ShangqunYu/Dash48V/README.md

# Dash48V
48v version motor controller board
