ShangqunYu/Dash48V/v1.0/production/Sample-BOM_JLCSMT (3).xlsx

Comment | Designator | Footprint | JLCPCB Part #（optional）
GRM32EC72A106KE05L | C1, C2, C3, C4, C5, C6, C7, C8, C9, C10, C11, C12, C13, C14, C15, C16, C17, C18, C19, C21 | GRM32EC72A106KE05L | GRM32EC72A106KE05L
CL31B105KCHNNNE | C20 | CL31B105KCHNNNE | CL31B105KCHNNNE
GRM21BC72A105KE01L | C22, C28, C29, C30 | GRM21BC72A105KE01L | GRM21BC72A105KE01L
CC0603KRX7R0BB473 | C23 | CC0603KRX7R0BB473 | CC0603KRX7R0BB473
CL10B104KC8NNNC | C24, C47, C48, C49, C50, C51, C52, C53, C54, C55, C56, C57 | CL10B104KC8NNNC | CL10B104KC8NNNC
GRM155R60J475ME87D | C26 | GRM155R60J475ME87D | GRM155R60J475ME87D
CL31B225KCHSNNE | C37 | CL31B225KCHSNNE | CL31B225KCHSNNE
CL10B222KB8NNNC | C38 | CL10B222KB8NNNC | CL10B222KB8NNNC
GRM31CR61E476ME44L | C39 | GRM31CR61E476ME44L | GRM31CR61E476ME44L
GRM32ER71E226KE15L | C40, C41 | GRM32ER71E226KE15L | GRM32ER71E226KE15L
CC0402JRNPO9BN560 | C42 | CC0402JRNPO9BN560 | CC0402JRNPO9BN560
CL10B332KB8NNNC | C43 | CL10B332KB8NNNC | CL10B332KB8NNNC
EFVH100ADA101M10C0 | CC1, CC2 | EFVH100ADA101M10C0 | EFVH100ADA101M10C0
XT30(2+2)PB-M.G.B | CN3(OUT)1, CN3(OUT)2 | XT30(2+2)PB-M.G.B | XT30(2+2)PB-M.G.B
LTST-C190KGKT | D1 | LTST-C190KGKT | LTST-C190KGKT
LTST-C191KRKT | D2 | LTST-C191KRKT | LTST-C191KRKT
BLM18AG601SN1D | FL1 | BLM18AG601SN1D | BLM18AG601SN1D
BM07B-GHS-TBT | J1 | BM07B-GHS-TBT | BM07B-GHS-TBT
BM06B-GHS-TBT(LF)(SN) | J2 | BM06B-GHS-TBT(LF)(SN) | BM06B-GHS-TBT(LF)(SN)
Conn_01x02_Pin | J3 | Conn_01x02_Pin | Conn_01x02_Pin
VLS5045EX-680M | L1 | VLS5045EX-680M | VLS5045EX-680M
DFE252012PD-2R2M=P2 | L2, L3 | DFE252012PD-2R2M=P2 | DFE252012PD-2R2M=P2
FDMT80080DC | Q1, Q2, Q3, Q4, Q5, Q6 | FDMT80080DC | FDMT80080DC
RT0402DRE0710KL | R2, R5 | RT0402DRE0710KL | RT0402DRE0710KL
RC0402FR-0710KL | R3, R4 | RC0402FR-0710KL | RC0402FR-0710KL
RT0603DRD07200KL | R6 | RT0603DRD07200KL | RT0603DRD07200KL
RC0402JR-07200RL | R7, R8 | RC0402JR-07200RL | RC0402JR-07200RL
ARG03BTC4533 | R9, R15 | ARG03BTC4533 | ARG03BTC4533
RC0402FR-0742K2L | R10 | RC0402FR-0742K2L | RC0402FR-0742K2L
RC0402FR-0780K6L | R11 | RC0402FR-0780K6L | RC0402FR-0780K6L
RC0402FR-0752K3L | R12 | RC0402FR-0752K3L | RC0402FR-0752K3L
RC0805FR-07100KL | R13 | RC0805FR-07100KL | RC0805FR-07100KL
RT0603BRD0749K9L | R14 | RT0603BRD0749K9L | RT0603BRD0749K9L
WSLF25121L000FEA | R16, R17, R18 | WSLF25121L000FEA | WSLF25121L000FEA
+5V TestPoint | TP3 | +5V TestPoint | +5V TestPoint
+3.3V TestPoint | TP4 | +3.3V TestPoint | +3.3V TestPoint
TP_Can_tx | TP5, TP6 | TP_Can_tx | TP_Can_tx
TP_CS | TP12 | TP_CS | TP_CS
STM32F446RET6 | U1 | STM32F446RET6 | STM32F446RET6
DRV8353SRTAR | U2 | DRV8353SRTAR | DRV8353SRTAR
MCP2542FD-E/MF | U3 | MCP2542FD-E/MF | MCP2542FD-E/MF
MA732GQ-Z | U4 | MA732GQ-Z | MA732GQ-Z
TPS629203DRLR | U5, U6 | TPS629203DRLR | TPS629203DRLR
LM5164DDAR | VR1 | LM5164DDAR | LM5164DDAR
CSTNE8M00G550000R0 | Y1 | CSTNE8M00G550000R0 | CSTNE8M00G550000R0
