ShangqunYu/Dash48V/v1.0/DashMotor48V.step

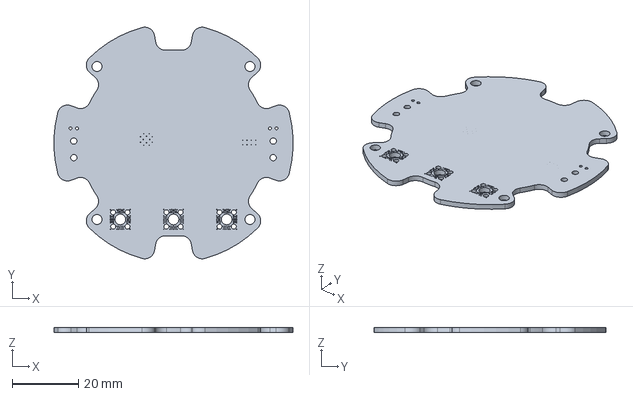
[picture p1: CAD file, 2025-12-12]
v1.0/DashMotor48V.step
71.9 x 69.7 x 1.51 mm
