ShangqunYu/Dash48V/(list of files, cad)

Other CAD files:
v1.0/DashMotor48V.3mf
