ShangqunYu/Dash48V/v1.0/DashMotor48V.kicad_pcb

## KiCad design v1.0/DashMotor48V.kicad_pcb (2026-07-16)

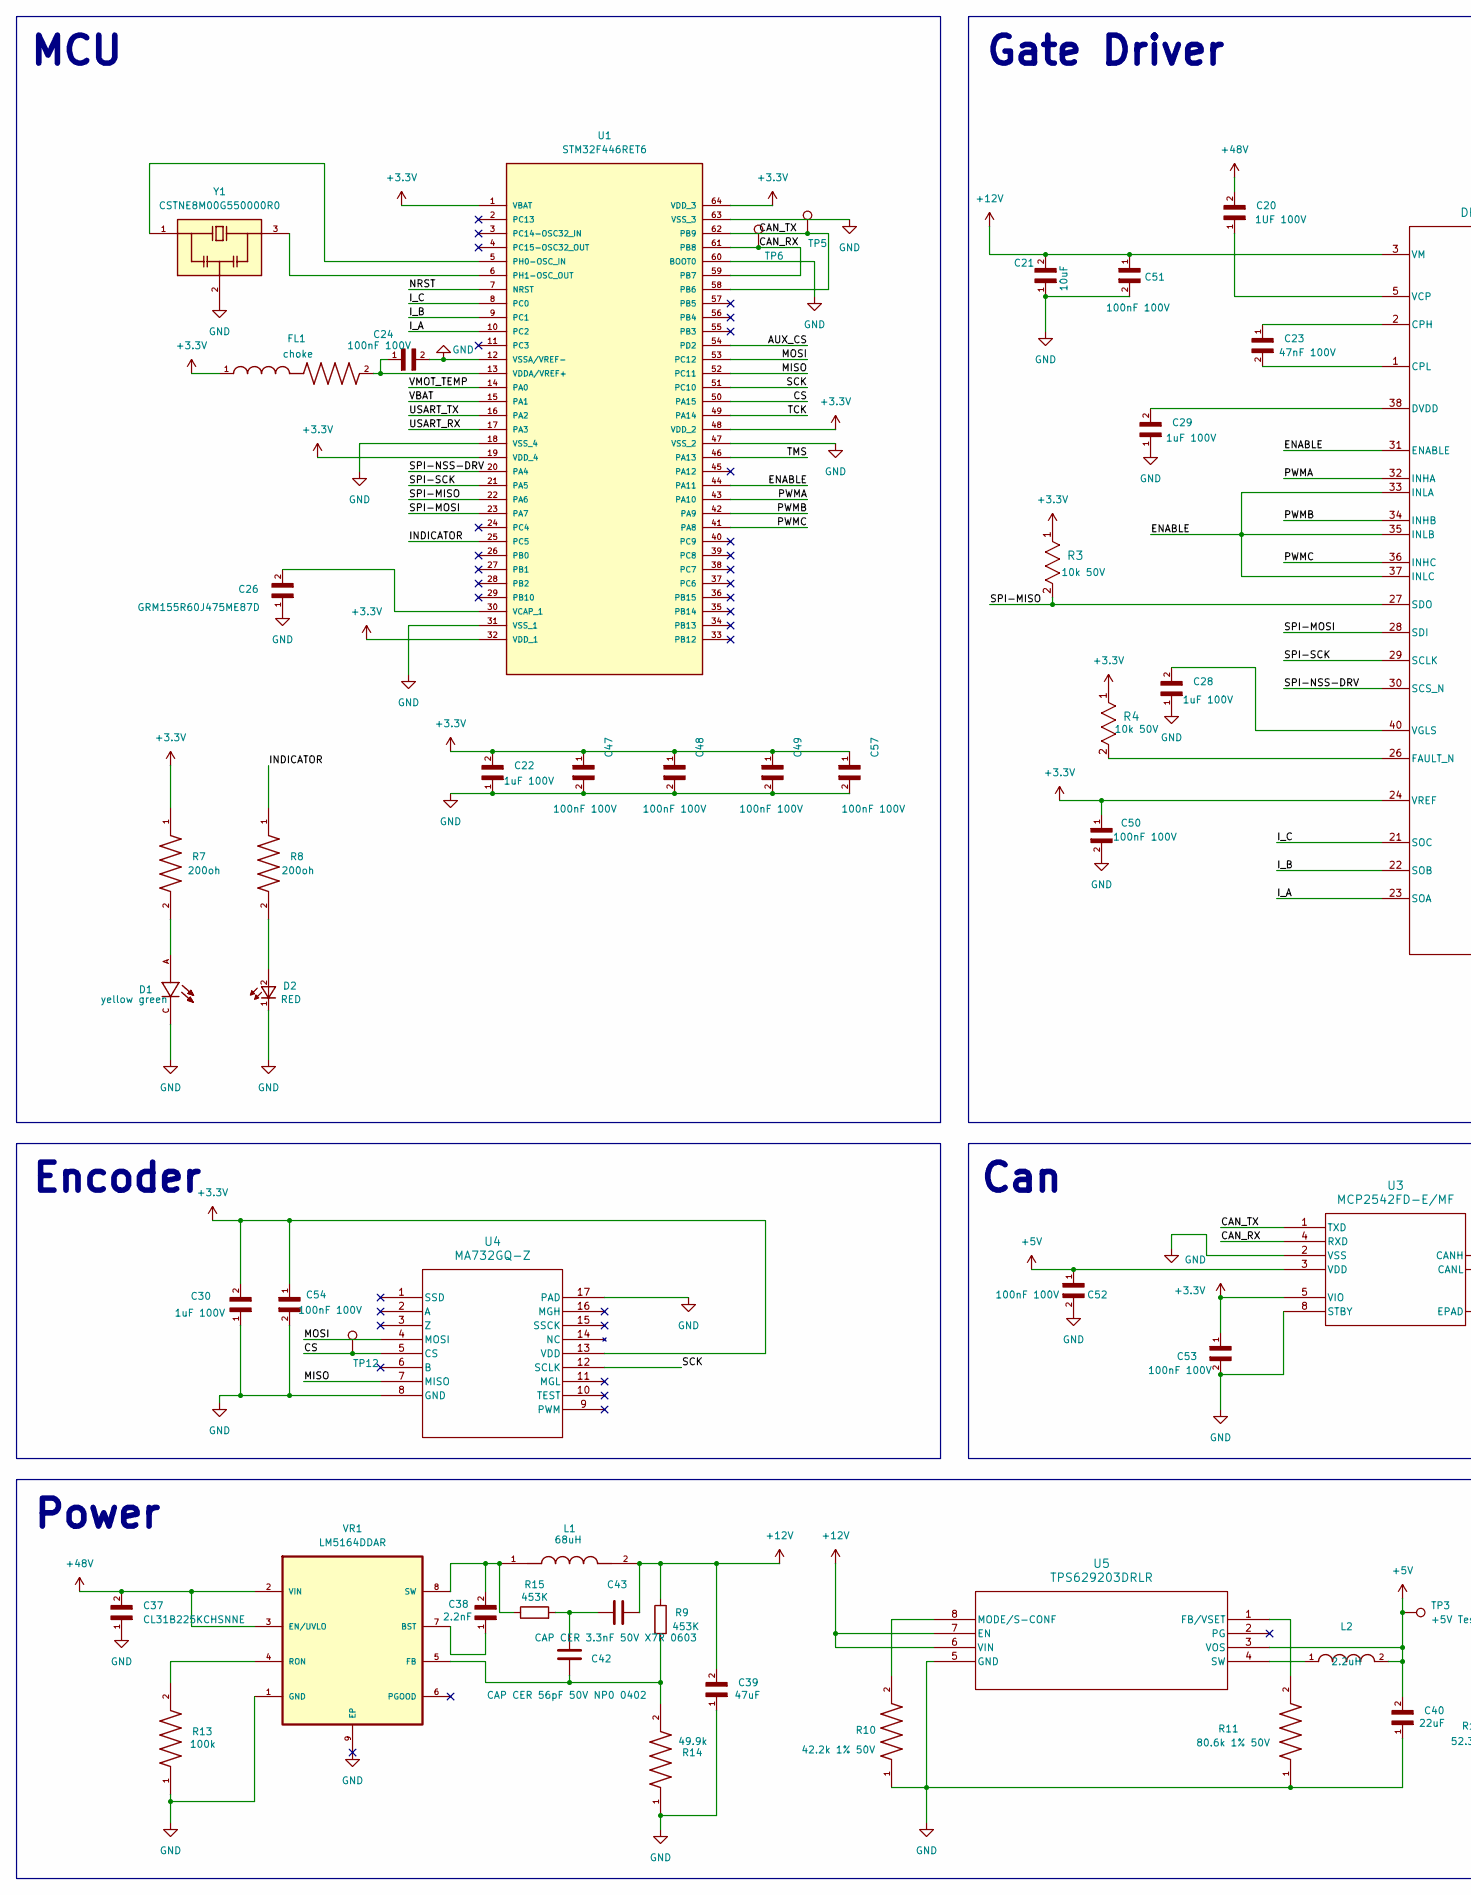
[picture p2: schematic DashMotor48V.kicad_sch, Dash 48V 1.0v, part in row 1, column 1]

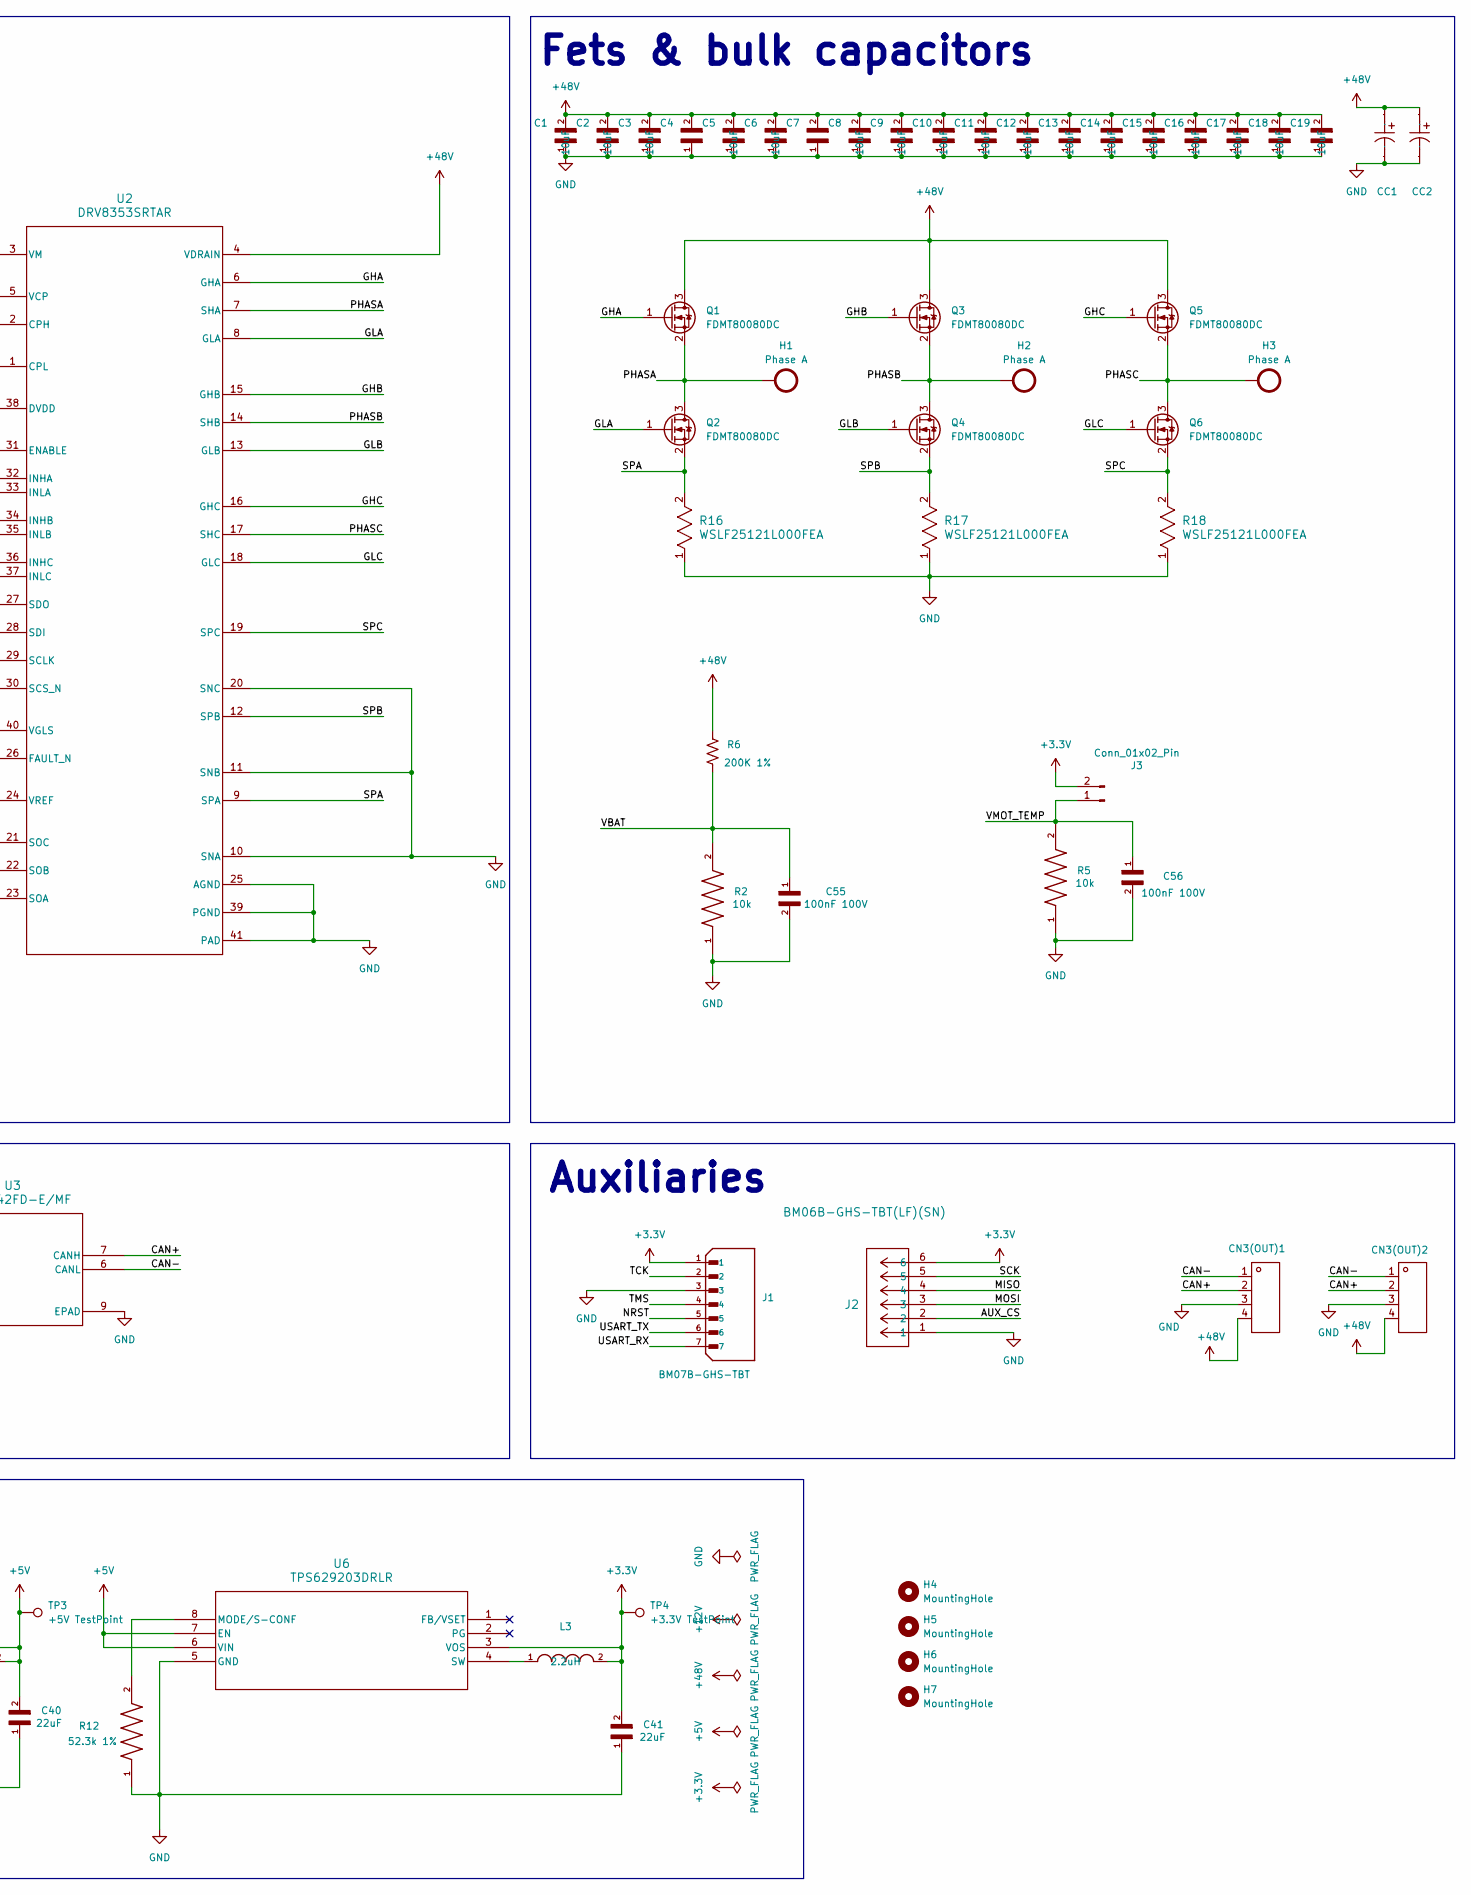
[picture p3: schematic DashMotor48V.kicad_sch, Dash 48V 1.0v, part in row 1, column 2]

Parts:
C1, C2, C3, C4, C5, C6, C7, C8, C9, C10, C11, C12, C13, C14, C15, C16, C17, C18, C19, C21: GRM32EC72A106KE05L
C20: CL31B105KCHNNNE
C22, C28, C29, C30: GRM21BC72A105KE01L
C23: CC0603KRX7R0BB473
C24, C47, C48, C49, C50, C51, C52, C53, C54, C55, C56, C57: CL10B104KC8NNNC
C26: GRM155R60J475ME87D
C37: CL31B225KCHSNNE
C38: CL10B222KB8NNNC
C39: GRM31CR61E476ME44L
C40, C41: GRM32ER71E226KE15L
C42: CC0402JRNPO9BN560; RC0402FR_0752K3L
C43: CL10B332KB8NNNC; CC0603JRX7R9BB104; JLCpart C1613
CC1, CC2: EFVH100ADA101M10C0; FOLLON EFVH100ADA101M10C0; Manufacturer Part EFVH100ADA101M10C0; LCSC Part Name 100uF ±20% 100V
CN3(OUT)1, CN3(OUT)2: XT30(2+2)PB-M.G.B; Manufacturer Part XT30(2+2)PB-M.G.B
D1: LTST-C190KGKT
D2: LTST-C191KRKT; LTST_C191KRKT
FL1: BLM18AG601SN1D
H1, H2, H3: Phase A; Pad_Square_Vias_6.5x6.5mm
H4, H5, H6, H7: MountingHole; MountingHole_2.2mm_M2_Pad
J1: BM07B-GHS-TBT; JST_BM07B-GHS-TBT; PARTREV NA
J2: BM06B-GHS-TBT(LF)(SN); BM06B-GHS-TBT
J3: Conn_01x02_Pin; PinHeader_1x02_P2.54mm_Vertical
L1: VLS5045EX-680M; VLS5045EX_680M; PARTREV N/A
L2, L3: DFE252012PD-2R2M=P2; DFE252012PD_2R2M_P2
Q1, Q2, Q3, Q4, Q5, Q6: FDMT80080DC; FDMT80040DC_compact
R2, R5: RT0402DRE0710KL
R3, R4: RC0402FR-0710KL; RC0402FR_0710KL
R6: RT0603DRD07200KL; YAGEO RC0603FR-07200KL
R7, R8: RC0402JR-07200RL
R9, R15: ARG03BTC4533; RT0603BRD07448KL
R10: RC0402FR-0742K2L; RC0402FR_0742K2L
R11: RC0402FR-0780K6L; RC0402FR_0780K6L
R12: RC0402FR-0752K3L; RC0402FR_0752K3L
R13: RC0805FR-07100KL; RC0805FR_07100KL
R14: RT0603BRD0749K9L
R16, R17, R18: WSLF25121L000FEA
TP3: +5V TestPoint; TestPoint_Pad_D1.0mm
TP4: +3.3V TestPoint; TestPoint_Pad_D1.0mm
TP5, TP6: TP_Can_tx; TestPoint_Pad_D1.0mm
TP12: TP_CS; TestPoint_Pad_D1.0mm
U1: STM32F446RET6; STM32F446RCT6
U2: DRV8353SRTAR
U3: MCP2542FD-E/MF; MCP2542FD_E_MF
U4: MA732GQ-Z
U5, U6: TPS629203DRLR
VR1: LM5164DDAR
Y1: CSTNE8M00G550000R0

Connections:
+3.3V: C22.2, C30.2, C41.2, C47.1, C48.1, C49.1, C50.1, C53.1, C54.1, C57.1, FL1.1, J1.1, J2.6, J3.2, L3.2, R3.1, R4.1, R7.1, TP4.1 (1_1), U1.1 (VBAT), U1.19 (VDD_4), U1.32 (VDD_1), U1.48 (VDD_2), U1.64 (VDD_3), U2.24 (VREF), U3.5 (VIO), U4.13 (VDD), U6.3 (VOS)
+5V: C40.2, C52.1, L2.2, TP3.1 (1_1), U3.3 (VDD), U5.3 (VOS), U6.6 (VIN), U6.7 (EN)
+12V: C21.2, C39.2, C43.2, C51.1, L1.2, R9.1, U2.3 (VM), U5.6 (VIN), U5.7 (EN)
+48V: C1.2, C2.2, C3.2, C4.2, C5.2, C6.2, C7.2, C8.2, C9.2, C10.2, C11.2, C12.2, C13.2, C14.2, C15.2, C16.2, C17.2, C18.2, C19.2, C20.2, C37.2, CC1.1, CC2.1, CN3(OUT)1.4, CN3(OUT)2.4, Q1.3 (D), Q3.3 (D), Q5.3 (D), R6.1, U2.4 (VDRAIN), VR1.2 (VIN), VR1.3 (EN/UVLO)
/AUX_CS: J2.2, U1.54 (PD2)
/CAN+: CN3(OUT)1.2, CN3(OUT)2.2, U3.7 (CANH)
/CAN-: CN3(OUT)1.1, CN3(OUT)2.1, U3.6 (CANL)
/CAN_RX: TP6.1 (1_1), U1.59 (PB7), U1.61 (PB8), U3.4 (RXD)
/CAN_TX: TP5.1 (1_1), U1.58 (PB6), U1.62 (PB9), U3.1 (TXD)
/CS: TP12.1 (1_1), U1.50 (PA15), U4.5 (CS)
/ENABLE: U1.44 (PA11), U2.31 (ENABLE), U2.33 (INLA), U2.35 (INLB), U2.37 (INLC)
/GHA: Q1.1 (G), U2.6 (GHA)
/GHB: Q3.1 (G), U2.15 (GHB)
/GHC: Q5.1 (G), U2.16 (GHC)
/GLA: Q2.1 (G), U2.8 (GLA)
/GLB: Q4.1 (G), U2.13 (GLB)
/GLC: Q6.1 (G), U2.18 (GLC)
/INDICATOR: R8.1, U1.25 (PC5)
/I_A: U1.10 (PC2), U2.23 (SOA)
/I_B: U1.9 (PC1), U2.22 (SOB)
/I_C: U1.8 (PC0), U2.21 (SOC)
/MISO: J2.4, U1.52 (PC11), U4.7 (MISO)
/MOSI: J2.3, U1.53 (PC12), U4.4 (MOSI)
/NRST: J1.5, U1.7 (NRST)
/PHASA: H1.1 (1_1), Q1.2 (S), Q2.3 (D), U2.7 (SHA)
/PHASB: H2.1 (1_1), Q3.2 (S), Q4.3 (D), U2.14 (SHB)
/PHASC: H3.1 (1_1), Q5.2 (S), Q6.3 (D), U2.17 (SHC)
/PWMA: U1.43 (PA10), U2.32 (INHA)
/PWMB: U1.42 (PA9), U2.34 (INHB)
/PWMC: U1.41 (PA8), U2.36 (INHC)
/SCK: J2.5, U1.51 (PC10), U4.12 (SCLK)
/SPA: Q2.2 (S), R16.2, U2.9 (SPA)
/SPB: Q4.2 (S), R17.2, U2.12 (SPB)
/SPC: Q6.2 (S), R18.2, U2.19 (SPC)
/SPI-MISO: R3.2, U1.22 (PA6), U2.27 (SDO)
/SPI-MOSI: U1.23 (PA7), U2.28 (SDI)
/SPI-NSS-DRV: U1.20 (PA4), U2.30 (SCS_N)
/SPI-SCK: U1.21 (PA5), U2.29 (SCLK)
/TCK: J1.2, U1.49 (PA14)
/TMS: J1.4, U1.46 (PA13)
/USART_RX: J1.7, U1.17 (PA3)
/USART_TX: J1.6, U1.16 (PA2)
/VBAT: C55.1, R2.2, R6.2, U1.15 (PA1)
/VMOT_TEMP: C56.1, J3.1, R5.2, U1.14 (PA0)
GND: C1.1, C2.1, C3.1, C4.1, C5.1, C6.1, C7.1, C8.1, C9.1, C10.1, C11.1, C12.1, C13.1, C14.1, C15.1, C16.1, C17.1, C18.1, C19.1, C21.1, C22.1, C24.2, C26.1, C28.1, C29.1, C30.1, C37.1, C39.1, C40.1, C41.1, C47.2, C48.2, C49.2, C50.2, C51.2, C52.2, C53.2, C54.2, C55.2, C56.2, C57.2, CC1.2, CC2.2, CN3(OUT)1.3, CN3(OUT)2.3, D1.C, D2.1, J1.3, J2.1, R2.1, R5.1, R10.1, R11.1, R12.1, R13.1, R14.1, R16.1, R17.1, R18.1, U1.12 (VSSA/VREF-), U1.18 (VSS_4), U1.31 (VSS_1), U1.47 (VSS_2), U1.60 (BOOT0), U1.63 (VSS_3), U2.10 (SNA), U2.11 (SNB), U2.20 (SNC), U2.25 (AGND), U2.39 (PGND), U2.41 (PAD), U3.2 (VSS), U3.8 (STBY), U3.9 (EPAD), U4.8 (GND), U4.17 (PAD), U5.5 (GND), U6.5 (GND), VR1.1 (GND), VR1.9 (EP), Y1.2
unnamed: C42.1, C43.1, R15.2
unnamed: D1.A, R7.2
unnamed: D2.2, R8.2
unnamed: U1.5 (PH0-OSC_IN), Y1.1
unnamed: U1.6 (PH1-OSC_OUT), Y1.3
unnamed: C26.2, U1.30 (VCAP_1)
unnamed: C24.1, FL1.2, U1.13 (VDDA/VREF+)
unnamed: C23.1, U2.2 (CPH)
unnamed: C23.2, U2.1 (CPL)
unnamed: C29.2, U2.38 (DVDD)
unnamed: R4.2, U2.26 (FAULT_N)
unnamed: C20.1, U2.5 (VCP)
unnamed: C28.2, U2.40 (VGLS)
unnamed: R11.2, U5.1 (FB/VSET)
unnamed: R10.2, U5.8 (MODE/S-CONF)
unnamed: L2.1, U5.4 (SW)
unnamed: R12.2, U6.8 (MODE/S-CONF)
unnamed: L3.1, U6.4 (SW)
unnamed: C38.1, VR1.7 (BST)
unnamed: C42.2, R9.2, R14.2, VR1.5 (FB)
unnamed: R13.2, VR1.4 (RON)
unnamed: C38.2, L1.1, R15.1, VR1.8 (SW)

Notes on the sheet:
MCU
Auxiliaries
Gate Driver
Can
Encoder
Fets & bulk capacitors
Power

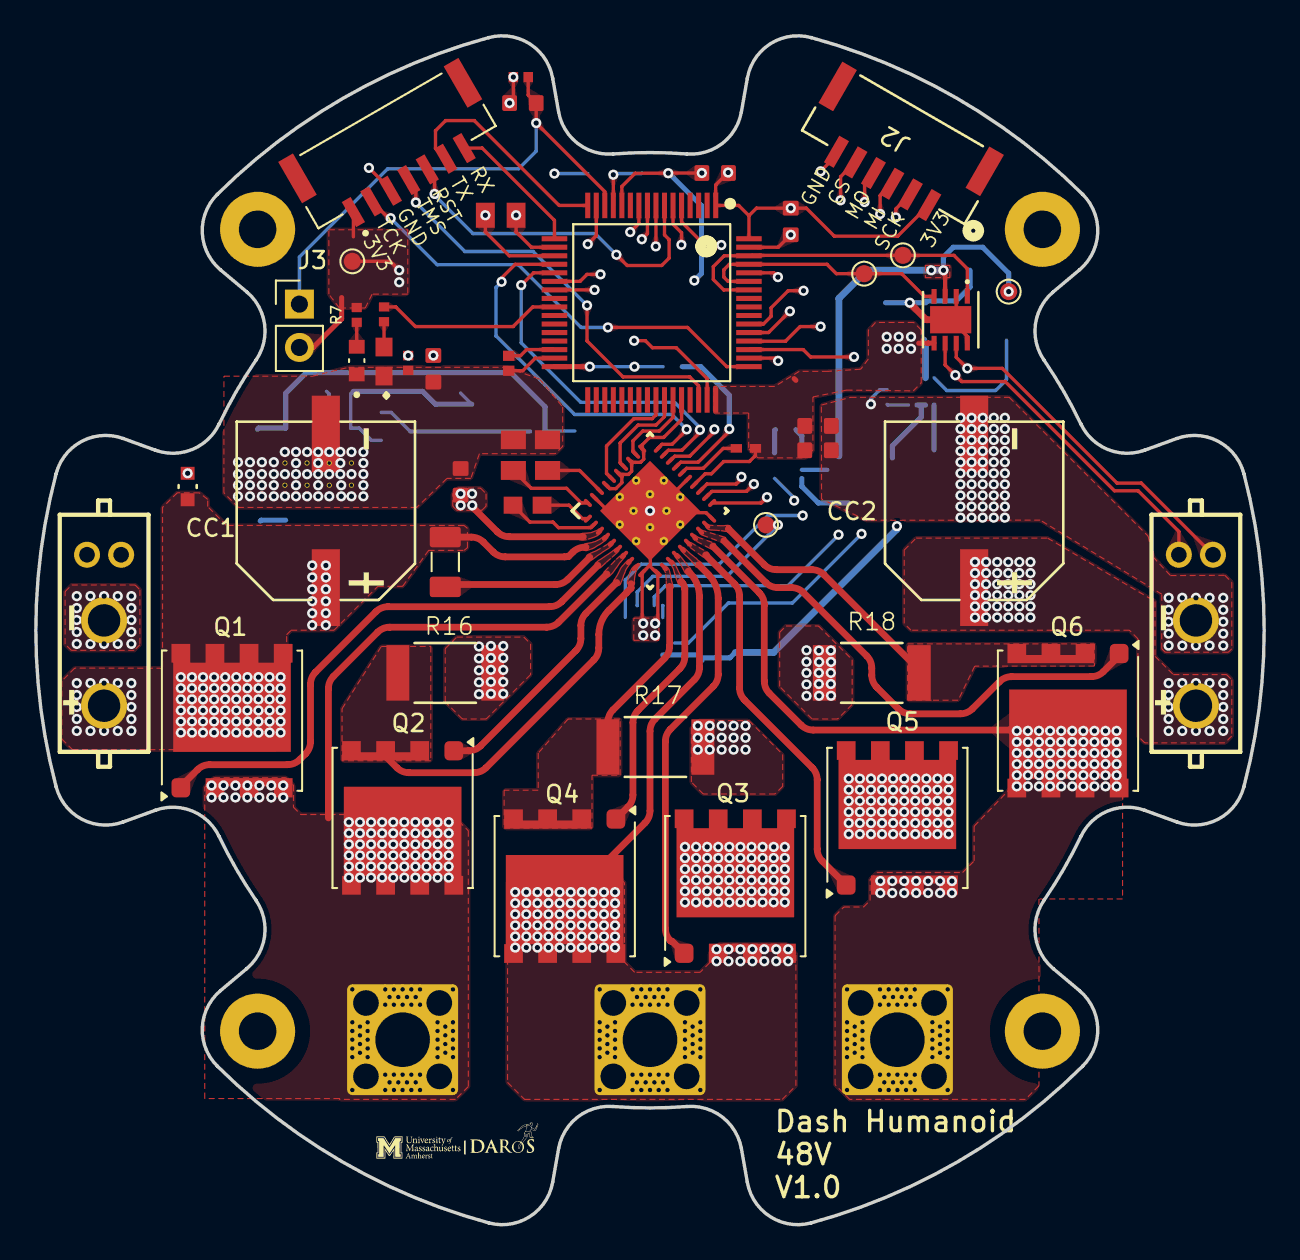
[picture p4: board DashMotor48V.kicad_pcb from above]

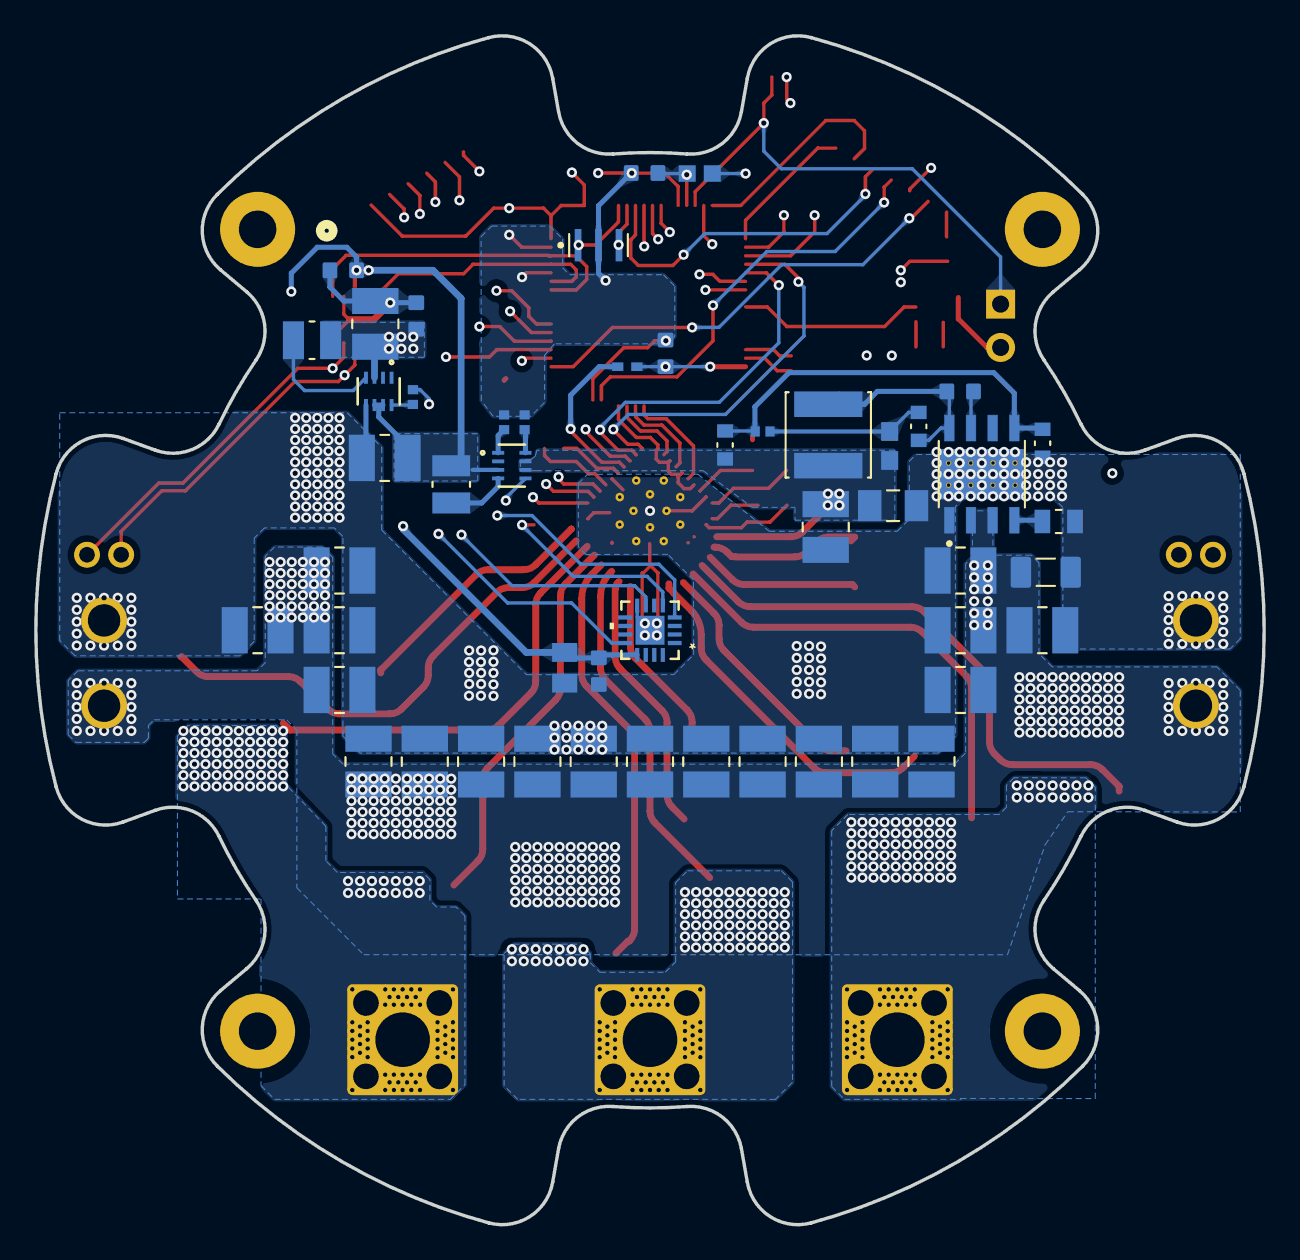
[picture p5: board DashMotor48V.kicad_pcb from below]

Board: 6 copper layers, 72.0 x 69.7 mm, 102 parts (50 on the bottom side), 67 nets.
