ShangqunYu/Dash48V/(commit log)

2025-12-01 Add README for Dash48V motor controller board
2025-12-01 first commit from laptop
    [DashMotor48V.kicad_pcb, DashMotor48V.kicad_sch]
2025-12-01 include the mosfet
    [DashMotor48V.kicad_sch]
2025-12-02 get can chip done
    [DashMotor48V.kicad_sch]
2025-12-02 finishing the routing
    [DashMotor48V.kicad_sch]
2025-12-02 start on routing
    [DashMotor48V.kicad_pcb, DashMotor48V.kicad_sch]
2025-12-03 finish schematic
    [DashMotor48V.kicad_sch]
2025-12-03 figure out the schematic
    [DashMotor48V.kicad_pcb, DashMotor48V.step]
2025-12-03 back up work on footprint
    [DashMotor48V.kicad_pcb, DashMotor48V.step]
2025-12-03 get the footprint for the bigger motor
    [DashMotor48V.kicad_sch]
2025-12-03 start placing
    [DashMotor48V.kicad_pcb, DashMotor48V.kicad_sch]
2025-12-04 put onto the board
    [DashMotor48V.kicad_pcb]
2025-12-05 have a good layout
    [DashMotor48V.kicad_pcb]
2025-12-07 1 draft
    [DashMotor48V.3mf, DashMotor48V.kicad_pcb, DashMotor48V.kicad_sch]
2025-12-08 power distribution + signal integrity improvements
    [DashMotor48V.kicad_pcb]
2025-12-08 will start 2nd version
    [DashMotor48V.kicad_pcb]
2025-12-11 formalize footprint and port
    [DashMotor48V.kicad_pcb]
2025-12-11 keep working on the 2nd version
    [DashMotor48V.kicad_pcb]
2025-12-11 keep working on 2nd version
    [DashMotor48V.kicad_pcb]
2025-12-12 work on 2ndraft
    [DashMotor48V.kicad_pcb, DashMotor48V.step]
2025-12-13 no error for the 2nd draft
    [DashMotor48V.kicad_pcb]
2025-12-14 minor tweak
    [DashMotor48V.kicad_pcb]
2025-12-15 change color and stuff
    [DashMotor48V.kicad_pcb, DashMotor48V.kicad_sch]
2025-12-16 need to add testing probe
    [DashMotor48V.kicad_pcb, DashMotor48V.kicad_sch]
2025-12-16 change a smaller shunt resistor and add more ground vias
    [DashMotor48V.kicad_pcb, DashMotor48V.kicad_sch]
2025-12-16 increase ground and 48v copper pour on layer six
    [DashMotor48V.kicad_pcb]
2025-12-17 Added TestPoints for Power
    [DashMotor48V.kicad_pcb, DashMotor48V.kicad_sch]
2025-12-17 added more testing point, replace obsolete part, final review
    [DashMotor48V.kicad_pcb, bom.csv, designators.csv, positions.csv]
2025-12-17 noticed they have stm32f446ret, will use that
    [DashMotor48V.kicad_pcb, DashMotor48V.kicad_sch, bom.csv]
2025-12-19 version sent to production
    [DashMotor48V.kicad_pcb, DashMotor48V.kicad_sch]
2026-04-15 make different version
    [DashMotor48V.3mf, DashMotor48V.kicad_pcb, DashMotor48V.kicad_sch, DashMotor48V.step, bom.csv, designators.csv, positions.csv]
2026-04-17 push to desktop
    [DashMotor48V.3mf, DashMotor48V.kicad_pcb, DashMotor48V.kicad_sch, DashMotor48V.step, bom.csv, designators.csv, positions.csv]
2026-04-17 keep working on v05
    [DashMotor48V.kicad_sch]
2026-04-20 back up
    [DashMotor48V.kicad_pcb, DashMotor48V.kicad_sch]
2026-04-20 clean up
    [DashMotor48V.3mf, DashMotor48V.kicad_pcb, DashMotor48V.kicad_sch, DashMotor48V.step, bom.csv, designators.csv, positions.csv]
2026-04-20 update pcb
    [DashMotor48V.kicad_pcb]
2026-04-20 upload again
    [DashMotor48V.kicad_pcb, DashMotor48V.kicad_sch]
2026-04-20 work on routing
    [DashMotor48V.kicad_pcb]
2026-04-24 keep routing
    [DashMotor48V.kicad_pcb, DashMotor48V.kicad_sch]
2026-04-27 finish first draft
    [DashMotor48V.kicad_pcb, DashMotor48V.kicad_sch]
2026-04-27 fix canrx tx pin place
    [DashMotor48V.kicad_pcb]
2026-04-27 keep tuning few things
    [DashMotor48V.kicad_pcb]
2026-04-29 adding more copper to the board
    [DashMotor48V.kicad_pcb, DashMotor48V.kicad_sch]
2026-04-30 keep finishing it
    [DashMotor48V.kicad_pcb, DashMotor48V.kicad_sch]
2026-05-01 fine tune
    [DashMotor48V.kicad_pcb]
2026-05-01 doing fine touch for the routing, almost done
    [DashMotor48V.kicad_pcb, DashMotor48V.kicad_sch]
2026-06-30 start working on version 1
    [DashMotor48V-B_Mask.gbr, DashMotor48V-B_Paste.gbr, DashMotor48V-B_Silkscreen.gbr, DashMotor48V-Edge_Cuts.gbr, DashMotor48V-F_Mask.gbr, DashMotor48V-F_Paste.gbr, DashMotor48V-F_Silkscreen.gbr, DashMotor48V-L1 (Sig, TOP).gbr]
2026-07-16 push 1.0
    [DashMotor48V-B_Mask.gbr, DashMotor48V-B_Paste.gbr, DashMotor48V-B_Silkscreen.gbr, DashMotor48V-Edge_Cuts.gbr, DashMotor48V-F_Mask.gbr, DashMotor48V-F_Paste.gbr, DashMotor48V-F_Silkscreen.gbr, DashMotor48V-L1 (Sig, TOP).gbr]
